masoud-engineer/Automatic-CAN-based-Headlight-Control-System/Image.png

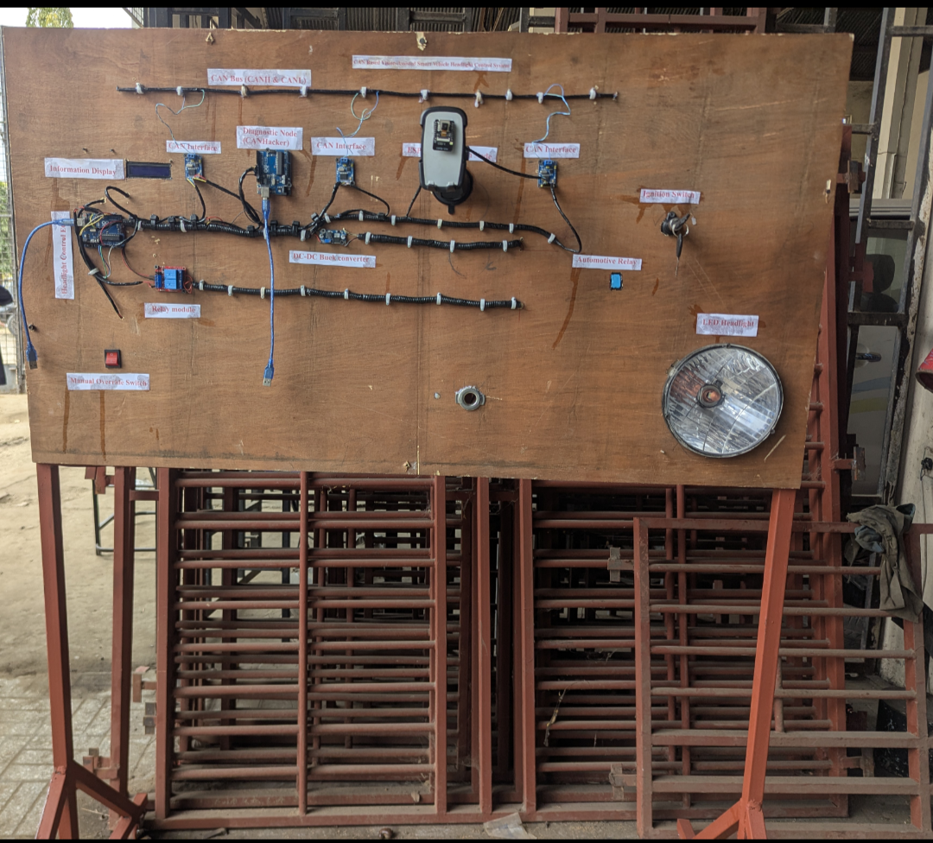
Image.png
