masoud-engineer/Automatic-CAN-based-Headlight-Control-System/Circuit Diagram.pdf

# VCC GND H L

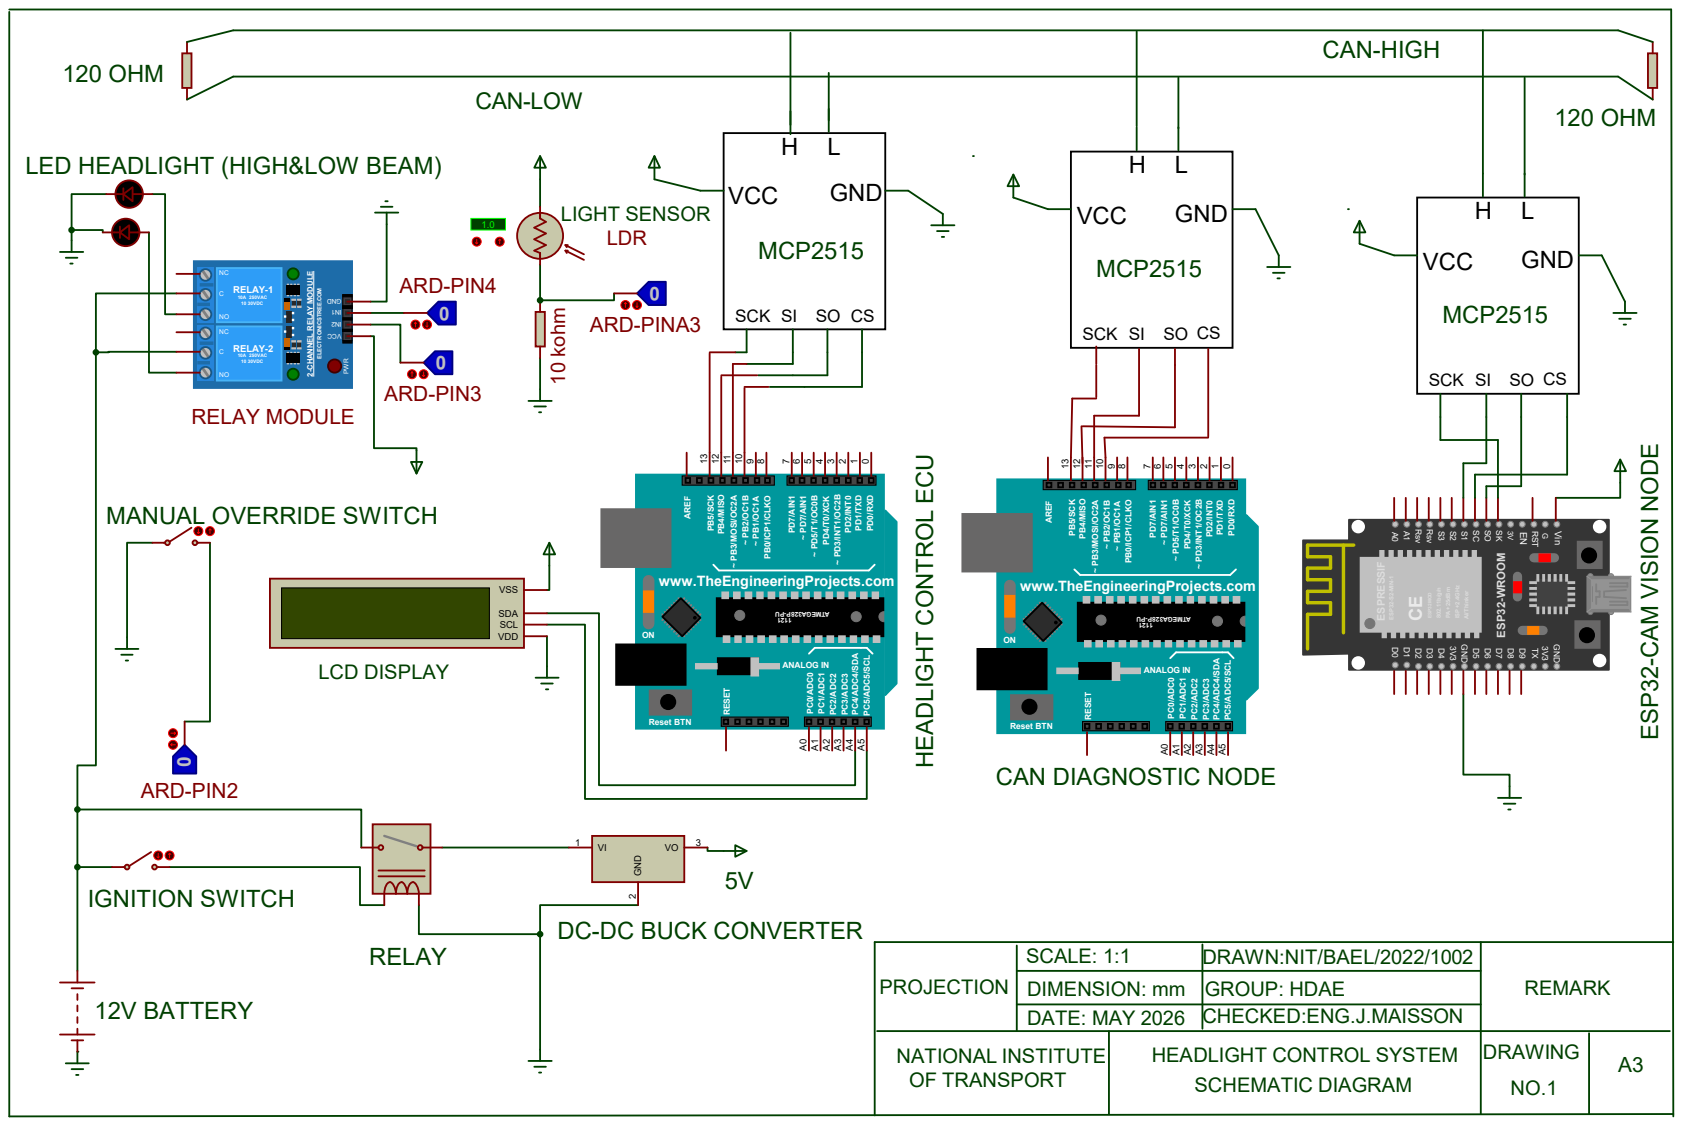
[picture p2: page 1]

LED HEADLIGHT (HIGH&LOW BEAM)

SCK SI SO CS

D1D2 D3 D4 3V3 GND D5 D6 D7 D8 D9 A0 D0 A1 Rsv Rsv S3S2S1 SCSOSK3VEN ESPRESSIF ESP32-S2-MIN-1 ESP32MOD 802.11b/g/n PA +25dBm ISP +2.4GHz AI/Thinker 3V3 GND TX ESP32-WROOM RST GVin CE

PROJECTION | SCALE: 1:1 | DRAWN:NIT/BAEL/2022/1002 | REMARK

DIMENSION: mm | GROUP: HDAE
DATE: MAY 2026 | CHECKED:ENG.J.MAISSON

NATIONAL INSTITUTE OF TRANSPORT | HEADLIGHT CONTROL SYSTEM SCHEMATIC DIAGRAM | NO.1 | A3 DRAWING
